matteotonini2003/CMOS-OTA-Analog-Design/doc/Relazione_Ota_p_v1_Tonini_Tuma.pdf

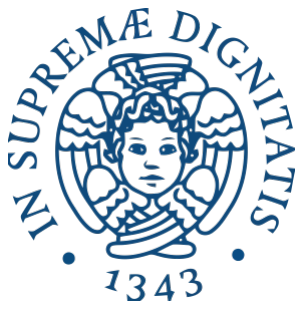
[picture p1: figure]

## UNIVERSITÀ DI PISA

PROGETTAZIONE DI SISTEMI MICROELETTRONICI – MODULO MICROELETTRONICA ANALOGICA

PROGETTO DI UN OTA CMOS DI TIPO P

Author(s)
Matteo Tonini
Antonio Tuma

Docente: Prof. Paolo Bruschi

Anno Accademico 2025/2026

# Indice

1 Introduzione e specifiche del progetto | 1
2 Dimensionamento dei transistor | 4
3 Simulazioni LTspice | 8
4 Layout | 17
5 Verifiche DRC, estrazione e LVS | 19
6 Conclusioni | 26

I

## CAPITOLO 1

# Introduzione e specifiche del progetto

L’obiettivo del progetto è la progettazione, la simulazione e la verifica tramite layout di un amplificatore operazionale transconduttivo CMOS di tipo p. Il circuito è costituito da una coppia differenziale di ingresso realizzata con transistor pMOS, da specchi di corrente nMOS e pMOS e da uno stadio di uscita ad alta impedenza.
Un OTA, a differenza di un amplificatore operazionale tradizionale, fornisce principalmente una corrente di uscita proporzionale alla tensione differenziale applicata agli ingressi. La tensione differenziale di ingresso è definita come:
vd = Vin1 − Vin2 | (1.1)

mentre la tensione di modo comune è:

VC =

Vin1 + Vin2
2 | (1.2)

Nel circuito assegnato, la coppia differenziale pMOS M1-M2 ripartisce la corrente di polarizzazione I0 tra i due rami. In assenza di segnale differenziale, cioè per vd = 0, le due correnti di drain risultano idealmente uguali:

ID1 = ID2 =

I0
2 | (1.3)

Le correnti generate dalla coppia differenziale vengono poi copiate dagli specchi di corrente. Gli specchi M3-M5 e M4-M6 sono dimensionati con rapporto di corrente pari a KI , mentre lo specchio M8-M7 ha rapporto unitario. Per piccoli segnali, la corrente di cortocircuito di uscita può essere espressa come:

iOCC = −gmKI vd | (1.4)

dove gm è la transconduttanza dei transistor della coppia differenziale. L’OTA è quindi caratterizzato da una transconduttanza equivalente:

Gm = gmKI | (1.5)

Il progetto è stato svolto seguendo il flusso full-custom previsto dal corso. In una prima fase abbiamo dimensionato i transistor e verificato il funzionamento del circuito tramite simulazioni LTspice. Successivamente abbiamo realizzato il layout in Glade ed effettuato le verifiche DRC e LVS.
Le specifiche assegnate per il progetto sono riportate in Tabella 1.1.
Poiché la topologia, le correnti di polarizzazione, i rapporti degli specchi e la lunghezza dei MOSFET sono fissati, il compito principale del dimensionamento consiste nel determinare le larghezze W dei transistor, cioè i relativi rapporti W/L. Il criterio seguito è stato quello di ottenere, per tutti i MOSFET, un valore di overdrive vicino a 200, mV, in modo da garantire il funzionamento in strong inversion nel rispetto delle specifiche.
Le simulazioni richieste comprendono la verifica del punto di riposo, il controllo della saturazione dei MOSFET, lo sweep della corrente di cortocircuito IOCC al variare della tensione differenziale VD per diversi valori della tensione di modo comune VC , e infine la simulazione a uscita aperta per stimare il guadagno di tensione dell’OTA.
Nei capitoli successivi vengono descritti il dimensionamento dei transistor, i risultati delle simulazioni LTspice, la realizzazione del layout e le verifiche finali DRC e LVS.

Parametro | Valore
Tipo di circuito | OTA CMOS di tipo p
Alimentazione | VDD = 2.5 V
Corrente di riferimento | IB = 9 µA
Corrente di polarizzazione | I0 = 18 µA
Rapporto degli specchi principali | KI = 2
Rapporto dello specchio M8-M7 | 1
Lunghezza dei MOSFET | L = 1 µm
Overdrive richiesto | |VGS − Vth| ≃ 200 mV
Tolleranza sull’overdrive | ±20 mV
Tecnologia | PSM025

Tabella 1.1: Specifiche principali assegnate per il progetto dell’OTA CMOS di tipo p.

## CAPITOLO 2

# Dimensionamento dei transistor

Il dimensionamento dei MOSFET è stato effettuato partendo dall’ipotesi di funzionamento in strong inversion e utilizzando la relazione quadratica della corrente di drain:

ID =

1
2

β (VGS − Vth)

2
(2.1)

dove β è il parametro del transistor, definito come:

β = µCox

W
L

(2.2)

Da questa relazione si ricava il valore dell’overdrive:

VGS − Vth =

s
2ID
β

(2.3)

Nel caso dei transistor pMOS, il valore di VGS − Vth è stato considerato in modulo. La specifica di progetto richiedeva infatti di ottenere, per tutti i MOSFET, un valore di overdrive circa pari a:

|VGS − Vth| ≃ 200 mV | (2.4)

con una tolleranza di circa ±20 mV.

### 2.1 Dimensionamento preliminare

Inizialmente, si considerano i transistori attraversati da una corrente pari a:

ID = 9 µA | (2.5)

Questo valore corrisponde alla corrente di riposo nei transistor della coppia differenziale M1-M2 e nei transistor di riferimento degli specchi di corrente M3-M4 e M10. Infatti, essendo:

I0 = 18 µA | (2.6)

nel punto di riposo la corrente della coppia differenziale si divide idealmente in due parti uguali:

ID1 = ID2 =

I0
2
= 9 µA | (2.7)

Utilizzando la relazione quadratica dei MOSFET in strong inversion e imponendo un overdrive di circa 200 mV, si arriva ad un primo valore teorico della larghezza pari a circa:

Wp ≃ 9 µm | (2.8)

per i transistor pMOS attraversati da 9 µA, e a un valore pari a circa:

Wn ≃ 1.9 µm | (2.9)

per i transistor nMOS attraversati dalla stessa corrente.
Tutti i transistor sono stati dimensionati mantenendo la lunghezza fissata dal progetto:
L = 1 µm | (2.10)

### 2.2 Correzione delle larghezze tramite simulazione

I valori ottenuti dal calcolo teorico sono stati utilizzati come punto di partenza per il dimensionamento. Tuttavia, i modelli MOSFET utilizzati in LTspice non seguono perfettamente la legge quadratica ideale, poiché tengono conto di effetti reali del dispositivo non considerati nel modello semplificato.
Per questo motivo, dopo il primo calcolo teorico, sono state eseguite simulazioni del punto di riposo in LTspice. Dalla simulazione si ricava il valore effettivo dell’overdrive, indicato come:

(VGS − Vth)

∗ | (2.11)

dove l’asterisco indica il valore ottenuto dalla simulazione usando il rapporto iniziale (W/L)

∗
Se il valore simulato dell’overdrive risulta diverso dal valore desiderato, il rapporto W/L viene corretto tramite la relazione:
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
(VGS − Vth)

∗
(VGS − Vth)

2
| (2.12)

dove (VGS − Vth) rappresenta il valore target dell’overdrive, pari a circa 200 mV.
Applicando questa procedura e verificando iterativamente il punto di riposo in LTspice, si arriva ai valori finali:
Wp = 7.6 µm | (2.13)

per i transistor pMOS attraversati da 9 µA, e:

Wn = 2.32 µm | (2.14)

per i transistor nMOS attraversati da 9 µA.
Questi valori permettono di ottenere un overdrive vicino a 200 mV, coerente con la specifica di progetto.

### 2.3 Dimensionamento per proporzionalità

Una volta fissate le dimensioni dei transistor di riferimento attraversati da 9 µA, gli altri MOSFET sono stati dimensionati utilizzando una regola di proporzionalità rispetto alla corrente.
Mantenendo costanti la lunghezza L e l’overdrive VGS − Vth, la corrente di drain è circa proporzionale alla larghezza W del transistor. Di conseguenza, un transistor attraversato da una corrente doppia deve avere larghezza doppia.

Per i transistor pMOS attraversati da 18 µA, è stato scelto:

W = 2 · 7.6 µm = 15.2 µm | (2.15)

Per i transistor nMOS attraversati da 18 µA, è stato invece scelto:

W = 2 · 2.32 µm = 4.64 µm | (2.16)

In questo modo, lo specchio M10-M9 realizza il passaggio dalla corrente di riferimento:

IB = 9 µA | (2.17)

alla corrente di polarizzazione:

I0 = 18 µA | (2.18)

poiché M9 ha larghezza doppia rispetto a M10.
Analogamente, gli specchi M3-M5 e M4-M6 hanno rapporto pari a 2, poiché M5 e M6 hanno larghezza doppia rispetto a M3 e M4. In questo modo viene ottenuto il guadagno di corrente richiesto:
KI = 2 | (2.19)

Lo specchio M8-M7 è stato invece dimensionato con rapporto unitario, scegliendo la stessa larghezza per entrambi i transistor.

### 2.4 Dimensioni finali dei MOSFET

Le dimensioni finali utilizzate nel circuito sono riportate in Tabella 2.1.

### 2.5 Considerazioni finali sul dimensionamento

Il dimensionamento finale è stato ottenuto combinando un calcolo teorico preliminare con una successiva correzione tramite simulazioni LTspice. Il calcolo iniziale ha permesso di individuare un ordine di grandezza corretto per le larghezze dei MOSFET, mentre le simulazioni hanno permesso di correggere i valori tenendo conto del comportamento reale dei modelli del processo PSM025.
Le larghezze finali scelte rispettano i rapporti di corrente richiesti dagli specchi e permettono di ottenere valori di overdrive compatibili con la specifica di progetto. La verifica dettagliata del punto di riposo, degli overdrive effettivi e della saturazione dei MOSFET viene riportata nel capitolo successivo.

Transistor | Tipo | Corrente nominale | Dimensione scelta
M1, M2 | pMOS | 9 µA | W/L = 7.6/1
M10 | pMOS | 9 µA | W/L = 7.6/1
M9 | pMOS | 18 µA | W/L = 15.2/1
M7, M8 | pMOS | 18 µA | W/L = 15.2/1
M3, M4 | nMOS | 9 µA | W/L = 2.32/1
M5, M6 | nMOS | 18 µA | W/L = 4.64/1

Tabella 2.1: Dimensioni finali dei MOSFET utilizzate nel progetto.

## CAPITOLO 3

# Simulazioni LTspice

In questo capitolo vengono riportate le simulazioni LTspice eseguite sull’OTA CMOS di tipo p. Le simulazioni hanno avuto lo scopo di verificare il corretto punto di riposo del circuito, il rispetto della specifica sull’overdrive dei MOSFET, la saturazione dei dispositivi e il comportamento dell’OTA sia come amplificatore transconduttivo sia come amplificatore di tensione.

### 3.1 Schematico del circuito

Lo schematico LTspice dell’OTA progettato è riportato in Figura 3.1. Il circuito è composto dalla coppia differenziale pMOS M1-M2, dagli specchi di corrente nMOS M3-M5 e M4-M6, dallo specchio pMOS M7-M8 e dal ramo di polarizzazione M9-M10.
La corrente di riferimento IB viene copiata dallo specchio M9-M10, generando la corrente di polarizzazione I0. Nel nostro caso:
IB = 9 µA | (3.1)
I0 = 18 µA | (3.2)

In condizioni di riposo, la corrente I0 si divide idealmente in due parti uguali nei due transistor della coppia differenziale:

ID1 = ID2 =

I0
2
= 9 µA | (3.3)

### 3.2 Analisi del punto di riposo

Prima di eseguire le simulazioni in sweep, è stata effettuata un’analisi del punto di riposo tramite il comando .op di LTspice. Il testbench utilizzato per questa analisi è riportato in Figura 3.2.
Per l’analisi del punto di riposo sono stati impostati:

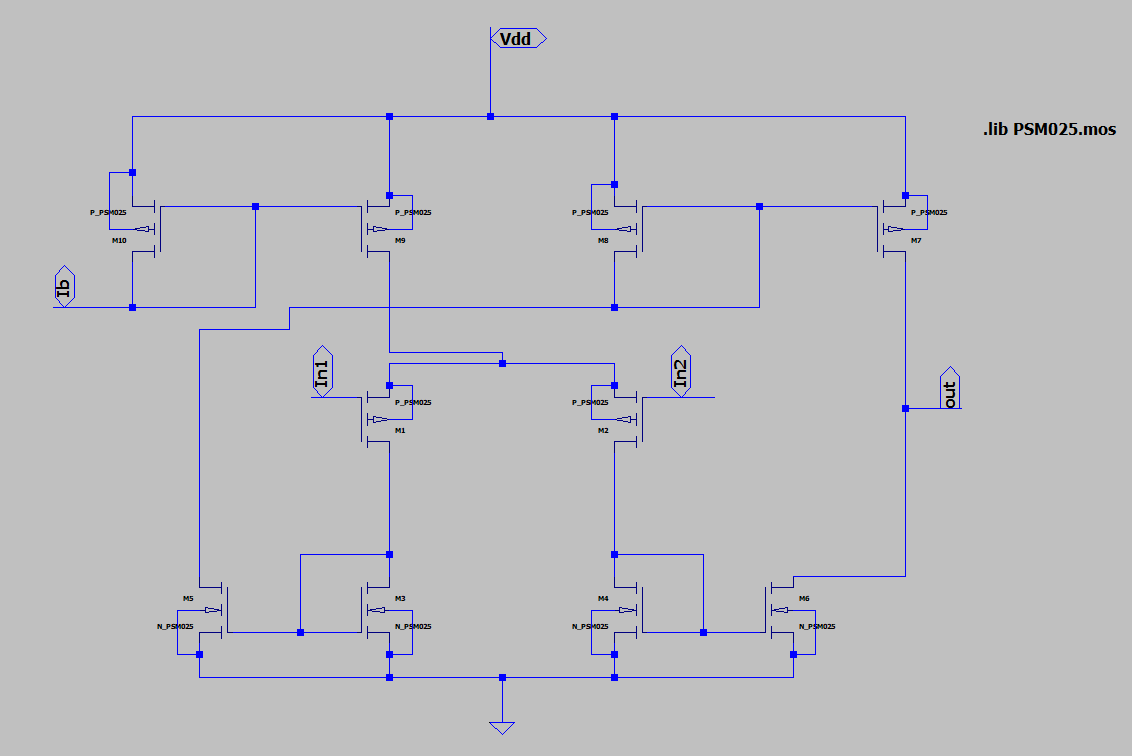
[picture p2: figure]

Figura 3.1: Schematico LTspice dell’OTA CMOS di tipo p.

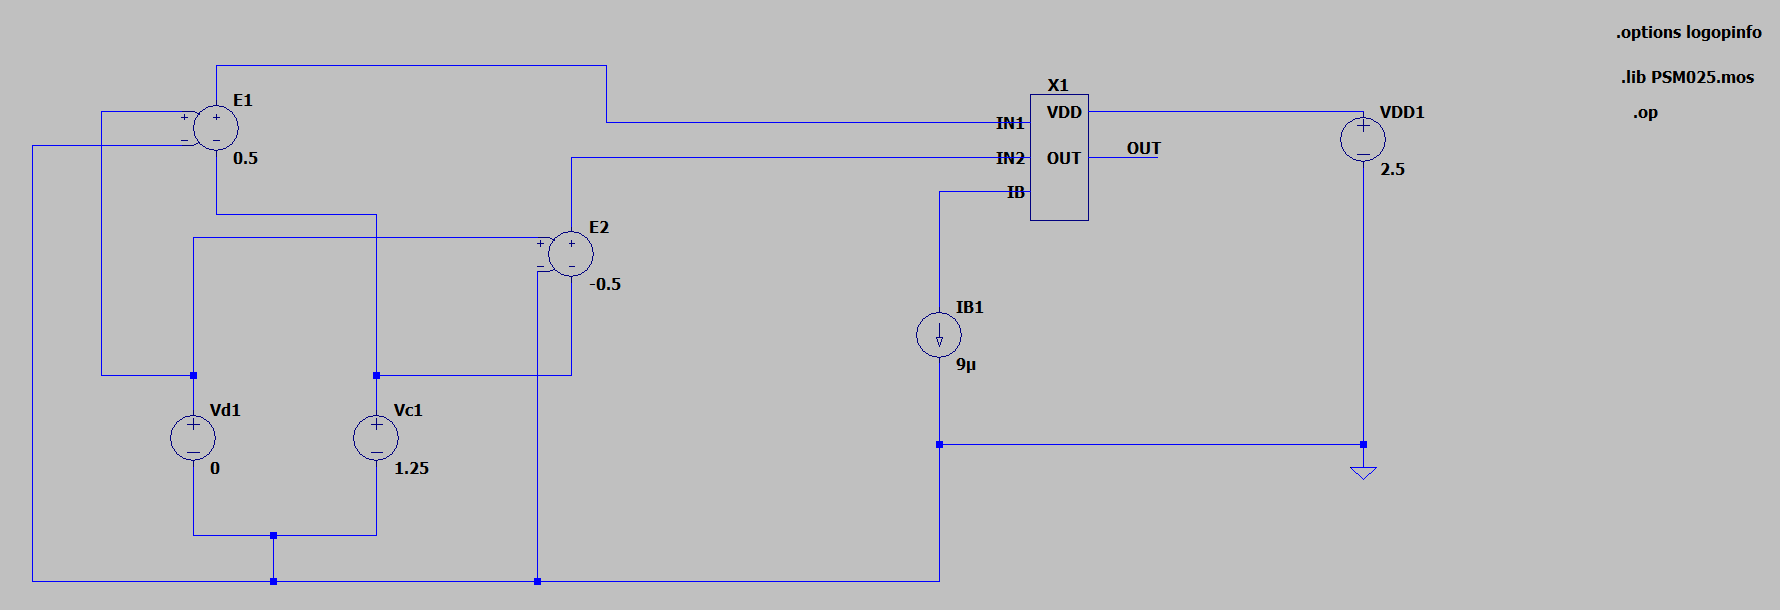
[picture p3: figure]

Figura 3.2: Testbench LTspice utilizzato per l’analisi del punto di riposo dell’OTA.

VC = 1.25 V | (3.4)

e:

VO = 1.25 V | (3.5)

La tensione di uscita è stata fissata a 1.25 V per mantenere correttamente polarizzati sia il transistor nMOS M6 sia il transistor pMOS M7. Infatti, collegare direttamente l’uscita a massa non sarebbe corretto, perché M6 avrebbe una tensione VDS nulla e non lavorerebbe correttamente in saturazione. Il log della simulazione del punto di riposo è riportato in Figura 3.3.
Dai risultati della simulazione si osserva che la coppia differenziale M1-M2 conduce circa metà della corrente I0:
|ID1| = |ID2| ≃ 8.92 µA | (3.6)

Questo valore è molto vicino al valore teorico:

I0
2
= 9 µA | (3.7)

Anche la polarizzazione degli specchi risulta coerente con il comportamento atteso. Il transistor M10 conduce circa:

|ID10| = 9.00 µA | (3.8)

mentre M9 conduce circa:

|ID9| = 17.8 µA | (3.9)

Lo specchio M9-M10 realizza quindi correttamente una corrente quasi doppia rispetto a IB.
Gli specchi M3-M5 e M4-M6 realizzano anch’essi il rapporto di corrente richiesto. Infatti, M3 e M4 conducono circa:
ID3 = ID4 ≃ 8.92 µA | (3.10)

mentre M5 e M6 conducono circa:

ID5 = ID6 ≃ 19.4 µA | (3.11)

Considerando le non idealità dei dispositivi reali e le diverse tensioni VDS dei transistor, questi valori risultano accettabili e coerenti con il funzionamento atteso degli specchi di corrente.

### 3.3 Verifica degli overdrive e della saturazione

Dall’analisi del punto di riposo sono stati ricavati gli overdrive dei MOSFET. Per gli nMOS è stato considerato:

VOV = VGS − Vth | (3.12)

mentre per i pMOS è stato considerato il valore in modulo:

VOV = |VGS − Vth| | (3.13)

I valori ottenuti sono riportati in Tabella 3.1.
Tutti i valori ottenuti sono compresi circa tra:
196 mV ≤ VOV ≤ 209 mV | (3.14)

Quindi tutti i MOSFET rispettano la specifica di progetto:

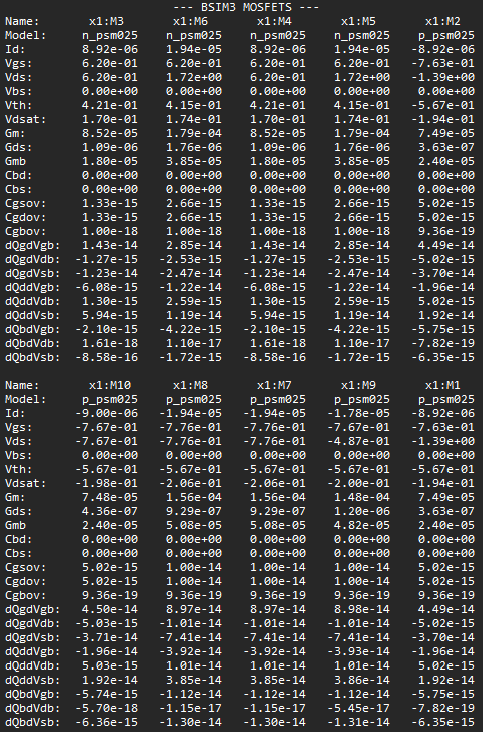
[picture p4: figure]

Figura 3.3: Risultati dell’analisi del punto di riposo ottenuti tramite simulazione .op in LTspice.

|VGS − Vth| = 200 mV ± 20 mV | (3.15)

È stata inoltre verificata la saturazione dei MOSFET. Per un nMOS la condizione verificata è:

VDS > VDSsat | (3.16)

mentre per un pMOS si confrontano i valori in modulo:

|VDS| > |VDSsat| | (3.17)

Dal log LTspice si osserva che tutti i transistor lavorano correttamente in saturazione. Il transistor M9 è quello con il margine minore, ma anche per esso la tensione |VDS| risulta maggiore di |VDSsat|.

### 3.4 Testbench per la corrente di cortocircuito

Per valutare il comportamento transconduttivo dell’OTA è stato utilizzato un secondo testbench, riportato in Figura 3.4. In questo caso l’uscita è stata forzata a una tensione costante tramite il generatore VO, in modo da simulare la condizione di cortocircuito in uscita.
Gli ingressi dell’OTA sono stati pilotati in modo da poter impostare separatamente la tensione differenziale VD e la tensione di modo comune VC . In particolare:

Vin1 = VC +

VD
2 | (3.18)

Vin2 = VC −

VD
2

(3.19)

La tensione di uscita è stata fissata a:

VO = 1.25 V | (3.20)

mentre la tensione differenziale è stata variata nell’intervallo:

−400 mV ≤ VD ≤ +400 mV | (3.21)

La simulazione è stata ripetuta per i seguenti valori della tensione di modo comune:

VC = 0 V; 0.5 V; 1 V; 1.25 V; 2 V; 2.5 V | (3.22)

Il risultato della simulazione è riportato in Figura 3.5.
Dal grafico si osserva che, per valori intermedi della tensione di modo comune, la caratteristica attraversa l’origine ed è quasi simmetrica rispetto ad essa. Questo è coerente con il funzionamento atteso del circuito: per VD = 0, le correnti nei due rami della coppia differenziale sono circa uguali e quindi la corrente netta d’uscita è circa nulla.
Intorno a VD = 0, la caratteristica è quasi lineare. In questa zona vale la relazione:
IOCC ≃ −Gmvd | (3.23)

dove:

Gm = gmKI | (3.24)

Per valori elevati di |VD|, invece, la curva tende a saturare. Questo accade perché la coppia differenziale non lavora più in piccolo segnale: quasi tutta la corrente I0 viene convogliata in uno dei due rami, mentre l’altro ramo tende a spegnersi.
Il valore teorico massimo della corrente di cortocircuito è:
IOCC,max = KI I0 | (3.25)

Transistor | Overdrive simulato
M1, M2 | VOV = 0.196 V
M3, M4 | VOV = 0.199 V
M5, M6 | VOV = 0.205 V
M7, M8 | VOV = 0.209 V
M9, M10 | VOV = 0.200 V

Tabella 3.1: Valori di overdrive ottenuti dall’analisi del punto di riposo.

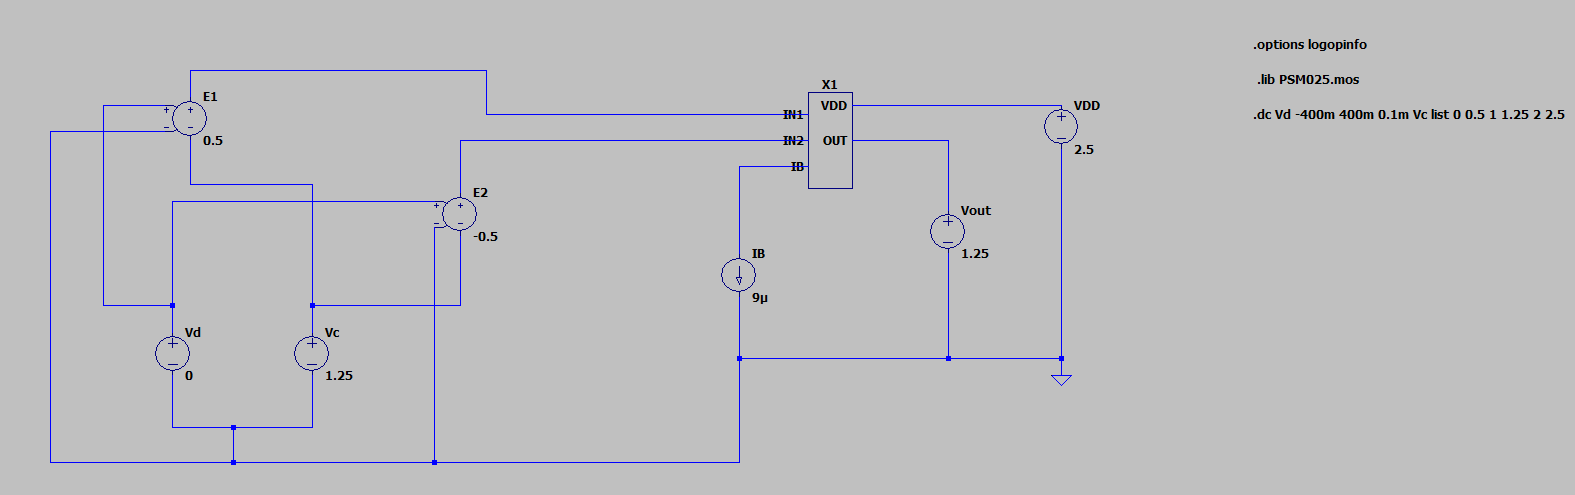
[picture p5: figure]

Figura 3.4: Testbench LTspice utilizzato per la simulazione della corrente di cortocircuito IOCC .

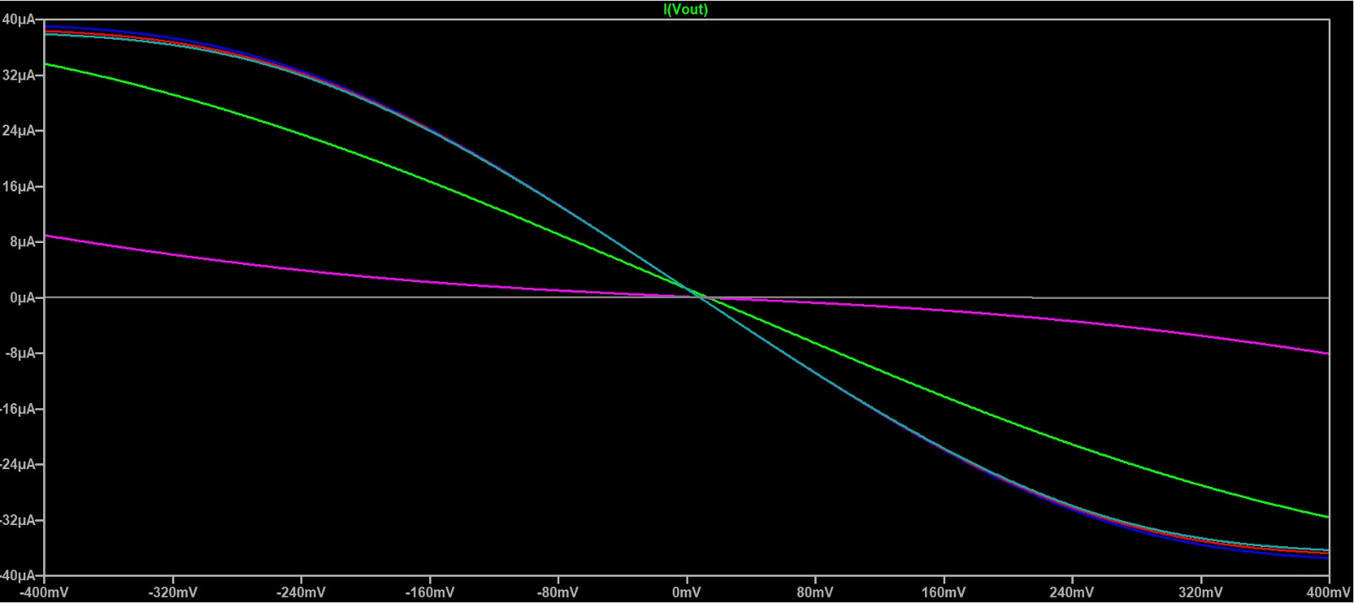
[picture p6: figure]

Figura 3.5: Corrente di cortocircuito IOCC in funzione della tensione differenziale VD per diversi valori della tensione di modo comune VC .

Sostituendo i valori del progetto:

IOCC,max = 2 · 18 µA = 36 µA | (3.26)

Dal grafico si osserva infatti che le curve principali tendono a valori vicini a ±36 µA, con piccole differenze dovute alle non idealità degli specchi di corrente e dei modelli MOS utilizzati nella simulazione.
Si nota inoltre che, per tensioni di modo comune elevate, in particolare per VC = 2 V e VC = 2.5 V, la caratteristica si deforma sensibilmente.

### 3.5 Simulazione a uscita aperta

Successivamente è stata eseguita una simulazione a uscita aperta, rimuovendo il generatore VO dal testbench. In questo modo il circuito non lavora più come generatore di corrente in cortocircuito, ma come amplificatore di tensione. Il testbench utilizzato è riportato in Figura 3.6.
La corrente differenziale generata dalla coppia di ingresso viene convertita in tensione sulla resistenza d’uscita equivalente:
Rout = rd6 ∥ rd7 | (3.27)

Il guadagno di tensione può quindi essere stimato come:

Av ≃ −gmKI (rd6 ∥ rd7) | (3.28)

oppure:

Av ≃ −GmRout | (3.29)

Nella simulazione è stato eseguito uno sweep della tensione differenziale VD, mantenendo:

VC = 1.25 V | (3.30)

Il risultato della simulazione è riportato in Figura 3.7.
Dal grafico si osserva che, per valori negativi della tensione differenziale, l’uscita tende al rail alto, vicino a VDD = 2.5 V. Per valori positivi di VD, invece, l’uscita scende verso il rail basso, cioè verso 0 V.
La caratteristica ha quindi un comportamento invertente: all’aumentare di VD, la tensione di uscita diminuisce. La transizione avviene in un intervallo ristretto di tensione differenziale, indicando un guadagno elevato nella zona centrale della caratteristica.
Nel grafico è riportata anche la derivata:
dV (out) dVD | (3.31)

che rappresenta il guadagno differenziale di tensione. Il valore massimo in modulo della derivata è circa:

|Av| ≃ 55 ÷ 60 | (3.32)

Possiamo quindi stimare:

Av ≃ −60 | (3.33)

In decibel:

Av[dB] = 20 log10(60) ≃ 35.6 dB | (3.34)

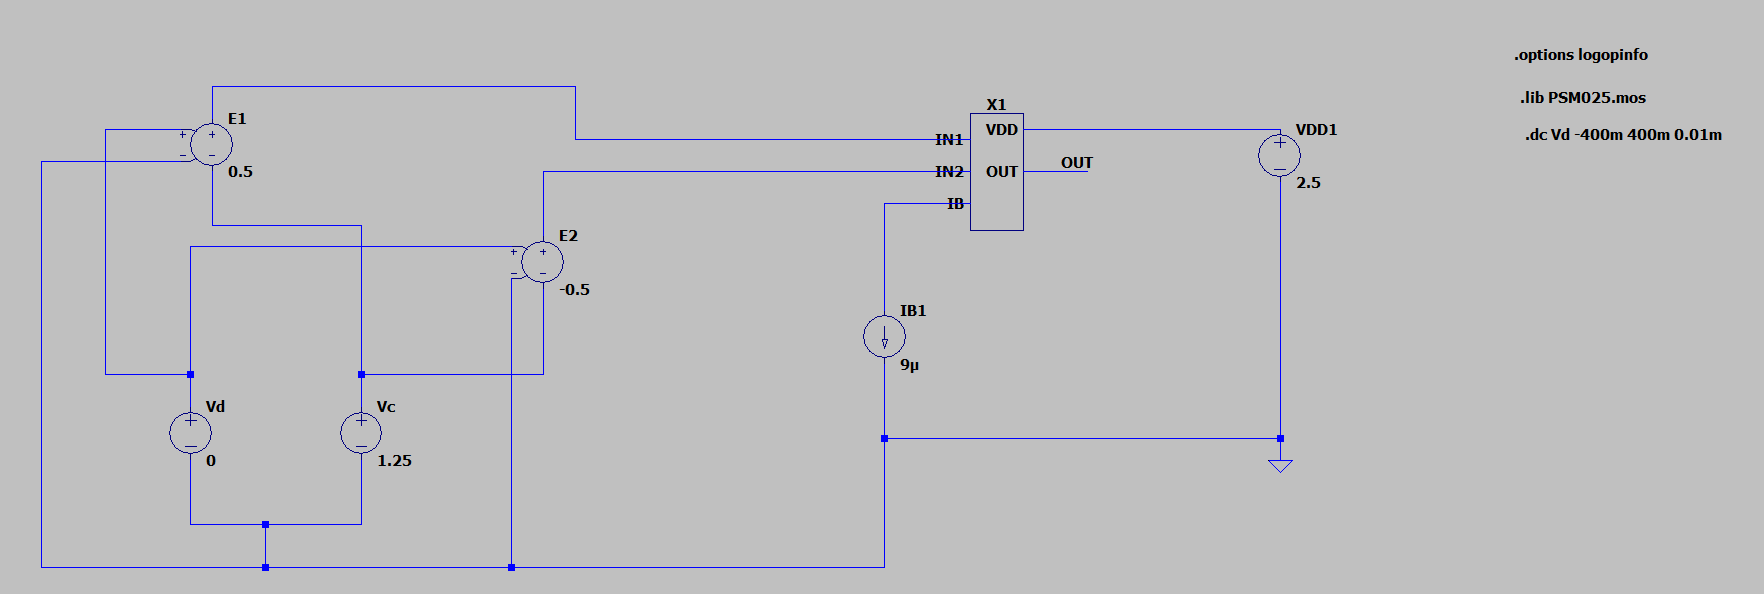
[picture p7: figure]

Figura 3.6: Testbench LTspice utilizzato per la simulazione dell’OTA a uscita aperta.

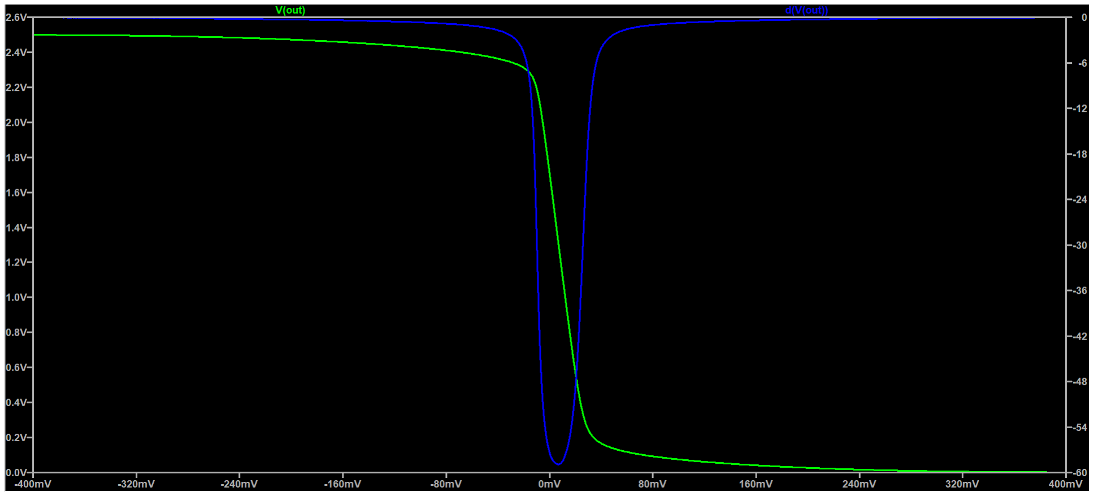
[picture p8: figure]

Figura 3.7: Tensione di uscita V (out) e derivata dV (out)/dVD nella simulazione a uscita aperta con VC = 1.25 V.

La zona utile di funzionamento quasi lineare è concentrata intorno alla transizione della curva V (out). Dal grafico si può stimare che questa zona corrisponda a valori di VD dell’ordine di alcune decine di millivolt, approssimativamente nell’intervallo:

−20 mV ≤ VD ≤ +20 mV | (3.35)

Fuori da questo intervallo, l’uscita tende ad avvicinarsi a uno dei due rail di alimentazione e il guadagno si riduce rapidamente.

## CAPITOLO 4

# Layout

Dopo aver verificato tramite simulazioni LTspice il corretto funzionamento dell’OTA CMOS di tipo p, è stato realizzato il layout del circuito utilizzando Glade. La cella realizzata è stata denominata OTA. L’obiettivo della fase di layout è stato quello di minimizzare l’area occupata dal chip, nel rispetto delle regole tecnologiche del processo PSM025.
Il layout completo dell’OTA è riportato in Figura 4.1.
La disposizione del layout segue la struttura elettrica del circuito. I transistor pMOS sono stati posizionati nella parte superiore della cella, in prossimità della linea di alimentazione VDD, mentre i transistor nMOS sono stati collocati nella parte inferiore, vicino alla linea di massa gnd.
Nel layout sono stati inoltre inseriti i contatti di well e di substrato necessari per polarizzare correttamente i bulk dei transistor. In particolare, i transistor pMOS sono stati realizzati all’interno di n-well collegati a VDD, mentre i bulk dei transistor nMOS sono stati collegati al substrato di tipo p tramite appositi substrate tap connessi a gnd. Questa scelta è necessaria per garantire la corretta polarizzazione dei dispositivi e per ottenere una netlist estratta coerente con quella dello schematico.
Le connessioni locali sono state realizzate principalmente tramite i livelli metallici disponibili nel processo. Le linee di alimentazione e massa sono state mantenute ben riconoscibili, rispettivamente nella parte superiore e inferiore del layout, mentre le connessioni di segnale sono state instradate in modo da collegare i dispositivi secondo la topologia dello schematico.
Le dimensioni complessive della cella sono riportate in Tabella 4.1.
L’area totale occupata dal layout è quindi:
Alayout = 17, µm · 42.5, µm | (4.1)
Alayout = 722.5, µm² | (4.2)

Il layout ottenuto mantiene una struttura compatta e ordinata, con separazione chiara tra la sezione pMOS superiore e la sezione nMOS inferiore. Le verifiche di correttezza fisica ed elettrica del layout, cioè DRC e LVS, vengono riportate nel capitolo successivo.

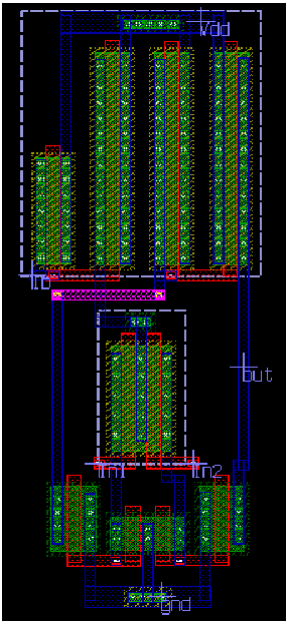
[picture p9: figure]

Figura 4.1: Layout completo della cella OTA realizzato in Glade.

Parametro | Valore
Nome della cella | OTA
Larghezza layout | 17, µm
Altezza layout | 42.5, µm
Area totale | 722.5, µm²
Tecnologia | PSM025

Tabella 4.1: Dimensioni complessive del layout della cella OTA.

## CAPITOLO 5

# Verifiche DRC, estrazione e LVS

Dopo la realizzazione del layout della cella OTA, sono state eseguite le verifiche finali tramite Glade. In particolare, sono state effettuate la verifica DRC, l’estrazione del layout e il confronto LVS tra la netlist estratta e la netlist dello schematico.
Per riportare i risultati in modo chiaro, i report generati dai tool sono stati inseriti direttamente nel testo della relazione utilizzando un font monospaziato.

### 5.1 Verifica DRC

La verifica DRC, cioè Design Rule Check, è stata eseguita per controllare che il layout rispettasse le regole geometriche della tecnologia PSM025.
Il report generato da Glade mostra che la verifica DRC è stata completata senza errori. Il risultato principale è:
No Errors Detected | (5.1)

Il report DRC è riportato nel Listato 5.1.

Listing 5.1: Report DRC generato da Glade.

Run DRC using rules file
C:/Users/luke6/OneDrive/Desktop/Universita/PSM_DK/psm_work_v2024/psm_work_v2024/glade/drc.py

# INFO: Read 2 raw shapes (2 merged) from layer n_well drawing

# INFO: Read 154 raw shapes (11 merged) from layer active drawing

# INFO: Read 22 raw shapes (6 merged) from layer poly drawing

# INFO: Read 5 raw shapes (5 merged) from layer n_plus drawing

# INFO: Read 6 raw shapes (6 merged) from layer p_plus drawing

# INFO: Read 150 raw shapes (146 merged) from layer contact drawing

# INFO: Read 182 raw shapes (11 merged) from layer metal1 drawing

# INFO: Read 2 raw shapes (2 merged) from layer via drawing

# INFO: Read 3 raw shapes (1 merged) from layer metal2 drawing

# INFO: Connectivity analysis may use 8 threads

# INFO: Set up tasks took 0.001 seconds

# INFO: Building connectivity graph, 8 tasks

# INFO: Build connectivity took 0.012 seconds

# INFO: Extract connectivity graph...

# INFO: Graph search took 0.002 seconds

# INFO: Total geomConnect time 0.018 seconds

Check n_well
Check active
Check poly
Check p_plus
Check n_plus
Check contact
Check metal1
Check via
Check metal2

No Errors Detected

# INFO: DRC run completed.

Il superamento del DRC conferma quindi che il layout non presenta violazioni geometriche rispetto alle regole tecnologiche utilizzate.

### 5.2 Estrazione del layout

Dopo la verifica DRC, è stata eseguita l’estrazione del layout tramite LPE, cioè Layout Parasitic Extraction.
Dal report di estrazione si osserva che i layer sono stati letti correttamente, che la connettività è stata costruita e che l’estrazione dei dispositivi MOS è stata completata. Il risultato principale è:
Extraction completed. | (5.2)

Il report di estrazione è riportato nel Listato 5.2.

Listing 5.2: Report di estrazione LPE generato da Glade.

Run LPE using rules file
C:/Users/luke6/OneDrive/Desktop/Universita/PSM_DK/psm_work_v2024/psm_work_v2024/glade/extract.py

# Loading pcells

ui().loadPCell("Progetto_OTA", "N_PSM025")

# WARNING: PCell N_PSM025 already loaded! Ignore reload.

ui().loadPCell("Progetto_OTA", "P_PSM025")

# WARNING: PCell P_PSM025 already loaded! Ignore reload.

# Get raw layers

# INFO: Read 2 raw shapes (2 merged) from layer n_well drawing

# INFO: Read 154 raw shapes (11 merged) from layer active drawing

# INFO: Read 22 raw shapes (6 merged) from layer poly drawing

# INFO: Read 5 raw shapes (5 merged) from layer n_plus drawing

# INFO: Read 6 raw shapes (6 merged) from layer p_plus drawing

# INFO: Read 150 raw shapes (146 merged) from layer contact drawing

# INFO: Read 182 raw shapes (11 merged) from layer metal1 drawing

# INFO: Read 2 raw shapes (2 merged) from layer via drawing

# INFO: Read 3 raw shapes (1 merged) from layer metal2 drawing

# Form derived layers

# Label nactivees

# WARNING: No text labels on layer potxt purpose drawing

# WARNING: No text labels on layer m2txt purpose drawing

# Form connectivity

# INFO: Connectivity analysis may use 8 threads

# INFO: Set up tasks took 0.007 seconds

# INFO: Building connectivity graph, 10 tasks

# INFO: Build connectivity took 0.014 seconds

# INFO: Extract connectivity graph...

# INFO: Graph search took 0.004 seconds

# INFO: Total geomConnect time 0.035 seconds

# Save interconnect

# INFO: 2 shapes saved for layer psub drawing

# INFO: 2 shapes saved for layer n_well drawing

# INFO: 9 shapes saved for layer active drawing

# INFO: 12 shapes saved for layer active drawing

# INFO: 6 shapes saved for layer poly drawing

# INFO: 146 shapes saved for layer contact drawing

# INFO: 11 shapes saved for layer metal1 drawing

# INFO: 2 shapes saved for layer via drawing

# INFO: 1 shapes saved for layer metal2 drawing

# INFO: Save Interconnect took 0.019 seconds

# Extract MOS devices

# Extraction completed.

ui().openCellView("Progetto_OTA", "OTA", "extracted", 1)

# INFO: Opened cell OTA view extracted

# INFO: LPE run completed.

La vista estratta della cella OTA è riportata in Figura 5.1.
L’estrazione risulta quindi completata correttamente e la vista extracted della cella OTA è stata generata.

### 5.3 Verifica LVS

Infine è stata eseguita la verifica LVS, cioè Layout Versus Schematic. Questa verifica confronta la netlist estratta dal layout con la netlist dello schematico.
Dal report si osserva che entrambe le netlist contengono lo stesso numero di dispositivi:
Ndevices = 10 | (5.3)

Inoltre, il report indica che non sono presenti errori sulle proprietà dei dispositivi:

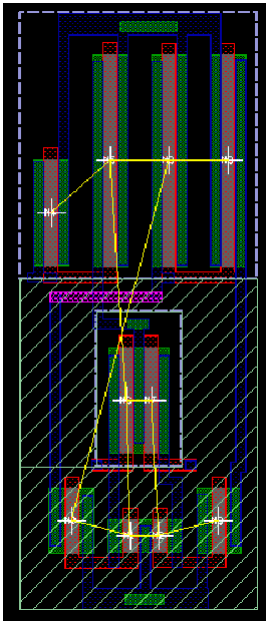
[picture p10: figure]

Figura 5.1: Vista extracted della cella OTA generata dopo l’estrazione LPE in Glade.

There were no device property errors. | (5.4)

Questo significa che i MOSFET estratti dal layout hanno dimensioni coerenti con quelle della netlist di riferimento.
Tuttavia, il report LVS segnala una differenza tra le netlist, dovuta a una mancata corrispondenza tra la rete n10 della netlist estratta e la rete gnd della netlist di riferimento. Questa anomalia riguarda il collegamento del substrato degli nMOS alla massa.
Il report LVS è riportato nel Listato 5.3.

Listing 5.3: Report LVS generato da Gemini.

1 ui().verifyLVSRun()

2
3 | ui().exportCDL("Progetto_OTA", "OTA", "extracted",
4 | "C:/Users/luke6/OneDrive/Desktop/Universita/PSM_DK/psm_work_v2024/psm_work_v2024/OTA_extracted.cdl
",
5 "", "(null)", 1, 0, 0, "r", 0, "c")

6
7 # INFO: Writing CDL file

8
9 # INFO: Finished writing CDL file

10
11 # INFO: Elapsed time = 0.003950s

12
13 # INFO: Starting LVS with args

14
15 | gemini.exe -C -v -P -w 10.000000
16 | -g C:\Users\luke6\OneDrive\Desktop\Universita\PSM_DK\psm_work_v2024\psm_work_v2024\OTA.err
17 | -S C:\Users\luke6\OneDrive\Desktop\Universita\PSM_DK\psm_work_v2024\psm_work_v2024\OTA_extracted.
cdl
18 C:\Users\luke6\OneDrive\Desktop\Progetto_OTA.cir

19
20 ---

21
22 ## Gemini 2.7.4 (64 bit)

23
24 Gemini started at 16:44:46 on 25/06/2026

25
26 ---

27
28 | ‘‘‘
29 | Netlist summary before reduction : OTA_extracted.cdl
30 | ‘‘‘

31
32 ---

33
34 | Number of devices : | 10
35 | Number of nets | : | 11
36 | Number of ports | : | 6

37
38 ---

39
40 | ‘‘‘
41 | Netlist summary before reduction : Progetto_OTA.cir
42 | ‘‘‘

43
44 ---

45
46 | Number of devices : | 10
47 | Number of nets | : | 10
48 | Number of ports | : | 0

49
50 ---

51
52 | ‘‘‘
53 | Netlist summary after reduction :
54 | ‘‘‘

55
56 ---

57
58 | ‘‘‘
59 | OTA_extracted.cdl | Progetto_OTA.cir
60 | ‘‘‘

61
62 | Number of devices : | 10 | 10
63 | Number of nets | : | 11 | 10
64 | Number of ports | : | 6 | 0

The circuits are different.

These circuits contain some symmetry (9% nodes not yet matched). Gemini will attempt to find a valid match for symmetrical nodes. There were no device property errors.
14 (66%) matches were found by local matching.

The following netlist mismatches occurred:

‘‘‘
Netlist errors : OTA_extracted.cdl ‘‘‘

2 NETS do not match:

NET "n10"[0,-1, BAD] 4 connections
N: (inst MM1) [g] n9 :: [s,d,sub] n9, gnd, n10 [l=1, w=2.32] N: (inst MM2) [g] n8 :: [s,d,sub] n8, gnd, n10 [l=1, w=2.32] N: (inst MM3) [g] n8 :: [s,d,sub] out, gnd, n10 [l=1, w=4.64] N: (inst MM0) [g] n9 :: [s,d,sub] n6, gnd, n10 [l=1, w=4.64]

NET "gnd"[0,-1, BAD] 4 connections
N: (inst MM1) [g] n9 :: [s,d,sub] n9, gnd, n10 [l=1, w=2.32] N: (inst MM2) [g] n8 :: [s,d,sub] n8, gnd, n10 [l=1, w=2.32] N: (inst MM3) [g] n8 :: [s,d,sub] out, gnd, n10 [l=1, w=4.64] N: (inst MM0) [g] n9 :: [s,d,sub] n6, gnd, n10 [l=1, w=4.64]

‘‘‘
Netlist errors : Progetto_OTA.cir

‘‘‘

1 NETS do not match:

NET "0"[0,-1, BAD] 8 connections
N: (inst M5) [g] N003 :: [s,d,sub] N001, 0, 0 [l=1, w=4.64] N: (inst M6) [g] N004 :: [s,d,sub] out, 0, 0 [l=1, w=4.64] N: (inst M4) [g] N004 :: [s,d,sub] N004, 0, 0 [l=1, w=2.32] N: (inst M3) [g] N003 :: [s,d,sub] N003, 0, 0 [l=1, w=2.32]

0 devices and 2 nets written to OTA.err

Gemini completed at 16:44:46 on 25/06/2026

# INFO: LVS finished with exit code 0

# INFO: LVS completed.

La differenza evidenziata dal tool riguarda quindi esclusivamente la rete di substrato degli nMOS. Nella netlist estratta, il terminale di substrato degli nMOS viene associato alla rete n10, mentre nella netlist dello schematico il substrato è collegato alla rete 0, cioè alla massa.
Questa anomalia è stata analizzata e non è stata ricondotta a un errore reale del layout. Il problema è dovuto a un bug o a una limitazione del software di estrazione/verifica nel riconoscimento del collegamento del substrato degli nMOS alla rete gnd.
Dal punto di vista circuitale, il layout risulta quindi coerente con lo schematico. In particolare:
- il numero di dispositivi estratti coincide con quello dello schematico;
- non sono presenti errori sulle proprietà dei dispositivi;
- le dimensioni dei MOSFET risultano correttamente riconosciute;
- l’unica differenza segnalata riguarda la gestione della rete di substrato degli nMOS.

Per questo motivo, nonostante il report LVS non riporti formalmente una completa corrispondenza tra le due netlist, il risultato è stato considerato corretto.

### 5.4 Considerazioni finali

Le verifiche finali confermano la correttezza del layout realizzato. La verifica DRC è stata superata senza errori, dimostrando il rispetto delle regole geometriche della tecnologia PSM025. L’estrazione LPE è stata completata correttamente e ha generato la vista extracted della cella OTA.
La verifica LVS ha evidenziato una differenza relativa alla rete di substrato degli nMOS, attribuita a un’anomalia del software di estrazione/verifica. Poiché il numero di dispositivi risulta corretto, non sono presenti errori sulle proprietà dei MOSFET e il problema è limitato alla gestione della connessione di substrato, il layout è stato considerato coerente con lo schematico e corretto per gli obiettivi del progetto.

## CAPITOLO 6

# Conclusioni

In questo progetto abbiamo realizzato il dimensionamento, la simulazione e il layout di un OTA CMOS di tipo p in tecnologia PSM025.
Il dimensionamento dei transistor è stato effettuato partendo dal modello quadratico dei MOSFET in strong inversion e successivamente corretto tramite simulazioni LTspice. Le larghezze finali scelte hanno permesso di ottenere valori di overdrive compatibili con la specifica richiesta.
Le simulazioni LTspice hanno confermato il corretto funzionamento del circuito. L’analisi del punto di riposo ha mostrato una corretta polarizzazione dei transistor e il rispetto delle condizioni di saturazione. La simulazione della corrente di cortocircuito ha evidenziato il comportamento transconduttivo dell’OTA, mentre la simulazione a uscita aperta ha permesso di stimare un guadagno di tensione pari a circa:
Av ≃ −60 | (6.1)

corrispondente a circa:

Av ≃ 35.6 dB | (6.2)

Successivamente è stato realizzato il layout della cella OTA in Glade. La verifica DRC è stata superata senza errori e l’estrazione del layout è stata completata correttamente. La verifica LVS ha evidenziato un’anomalia relativa al collegamento del substrato degli nMOS alla rete di massa, attribuita a un bug del software di estrazione/verifica e non a un errore reale del layout.
In conclusione, il circuito progettato soddisfa le specifiche richieste.
