matteotonini2003/CMOS-OTA-Analog-Design/ltspice/Schematico_Simulazioni.asc

E1: e; 0.5
E2: e; -0.5
IB: current; 9µ
Vc: voltage; 1.25
Vd: voltage; 0
VDD: voltage; 2.5
Vout: voltage; 1.25
X1: Progetto_Analogica_1
Named nets: 0
.options logopinfo
.lib PSM025.mos
.dc Vd -400m 400m 0.1m Vc list 0 0.5 1 1.25 2 2.5
