matteotonini2003/CMOS-OTA-Analog-Design/ltspice/Schematico_simulazioni_2.asc

E1: e; 0.5
E2: e; -0.5
IB1: current; 9µ
Vc: voltage; 1.25
Vd: voltage; 0
VDD1: voltage; 2.5
X1: Progetto_Analogica_1
Named nets: 0, OUT
.options logopinfo
.lib PSM025.mos
.dc Vd -400m 400m 0.01m
