matteotonini2003/CMOS-OTA-Analog-Design/ltspice/Progetto_Analogica_1.asc

M1: P_PSM025; l=1u w=7.6u
M2: P_PSM025; l=1u w=7.6u
M3: N_PSM025; l=1u w=2.32u
M4: N_PSM025; l=1u w=2.32u
M5: N_PSM025; l=1u w=4.64u
M6: N_PSM025; l=1u w=4.64u
M7: P_PSM025; l=1u w=15.2u
M8: P_PSM025; l=1u w=15.2u
M9: P_PSM025; l=1u w=15.2u
M10: P_PSM025; l=1u w=7.6u
Named nets: 0, Vdd, In1, In2, Ib, out
.lib PSM025.mos
