matteotonini2003/CMOS-OTA-Analog-Design/ltspice/Punto_di_riposo.asc

E1: e; 0.5
E2: e; -0.5
IB1: current; 9µ
Vc1: voltage; 1.25
Vd1: voltage; 0
VDD1: voltage; 2.5
X1: Progetto_Analogica_1
Named nets: 0, OUT
.options logopinfo
.lib PSM025.mos
.op
